simple-circuit/retro/scopewriter_pico50pwm/scopewriter_pico50pwm.ino

//    Pico Processor Scope Writer using PWM
//    Copyright (C) 2024  Simple-Circuit
//    This program displays a line of characters on an oscilloscope using
//    One I/O pin.
//
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

#include "pico/stdlib.h"
#include "hardware/pwm.h"
#include "hardware/clocks.h"

volatile word bc[128][8];    //ascii character pixel matrix
volatile word a[100];        //ascii character line

//Your oscilloscope horizontal scan time is us/div times total divisions
//My scope is 50us/div * 12 div = 6ms
//Character time is MAXCHAR * 7 * SYNCBIT * 2 = 5.6ms
//Character time must be less than the horizontal scan time
//Retrace time is Character time + SYNC1 + 2 * SYNC2 = 7.08ms
//Retrace time should be greater than the horizontal scan time

#define SYNC1 1000          //sync pulse delay counts us
#define SYNC2 240           //pre and post line delay us
#define MAXCHAR 50          //the size of the character display
#define SYNCBIT 8           //us clock pixel synchronization bit use 8,16,32

uint slice_num ;            //Global variable for PWM slice number

void setup() {
  //the PWM is set to 16 levels at 8MHz. Pin-14 is the output
    gpio_set_function(14, GPIO_FUNC_PWM);
    slice_num = pwm_gpio_to_slice_num(14);
    pwm_set_wrap(slice_num, 15);
    pwm_set_clkdiv(slice_num,1);
    pwm_set_chan_level(slice_num, PWM_CHAN_A, 8);
    pwm_set_enabled(slice_num, true);
 
  Serial.begin(115200); 
     
  int i;
  char message[] = "50 Character O'Scope Display #{67]*835?!14$%^&()=+/.,ABCDEFGHIJKLMNOPQRSTUVWXYZabcdefghijklmnopqrstuvwxyz?";
  for (i = 0; i < MAXCHAR; i++) a[i] = message[i];

//128 ascii character matrix values for a 5x7 pixel display
//A@
bc[ 0x40] [ 6 ] = B01110;
bc[ 0x40] [5 ] =  B10001;
bc[ 0x40] [4 ] =  B10111;
bc[ 0x40] [3 ] =  B11001;
bc[ 0x40] [ 2 ] = B10110;
bc[ 0x40] [ 1 ] = B10000;
bc[ 0x40] [ 0 ] = B01100;  
//A
bc[ 0x41] [ 6 ] = B00100;
bc[ 0x41] [5 ] =  B01010;
bc[ 0x41] [4 ] =  B10001;
bc[ 0x41] [3 ] =  B11111;
bc[ 0x41] [ 2 ] = B10001;
bc[ 0x41] [ 1 ] = B10001;
bc[ 0x41] [ 0 ] = B10001;
//B
bc[ 0x42] [ 6 ] = B11110;
bc[ 0x42] [ 5 ] = B10001;
bc[ 0x42] [ 4 ] = B10001;
bc[ 0x42] [ 3 ] = B11110;
bc[ 0x42] [ 2 ] = B10001;
bc[ 0x42] [ 1 ] = B10001;
bc[ 0x42] [ 0 ] = B11110;
//C
bc[ 0x43] [ 6 ] = B01111;
bc[ 0x43] [ 5 ] = B10000;
bc[ 0x43] [ 4 ] = B10000;
bc[ 0x43] [ 3 ] = B10000;
bc[ 0x43] [ 2 ] = B10000;
bc[ 0x43] [ 1 ] = B10000;
bc[ 0x43] [ 0 ] = B01111;
//D
bc[ 0x44] [ 6 ] = B11110;
bc[ 0x44] [ 5 ] = B10001;
bc[ 0x44] [ 4 ] = B10001;
bc[ 0x44] [ 3 ] = B10001;
bc[ 0x44] [ 2 ] = B10001;
bc[ 0x44] [ 1 ] = B10001;
bc[ 0x44] [ 0 ] = B11110;
//E
bc[ 0x45] [ 6 ] = B11111;
bc[ 0x45] [ 5 ] = B10000;
bc[ 0x45] [ 4 ] = B10000;
bc[ 0x45] [ 3 ] = B11110;
bc[ 0x45] [ 2 ] = B10000;
bc[ 0x45] [ 1 ] = B10000;
bc[ 0x45] [ 0 ] = B11111;
//F
bc[ 0x46] [ 6 ] = B11110;
bc[ 0x46] [ 5 ] = B10000;
bc[ 0x46] [ 4 ] = B10000;
bc[ 0x46] [ 3 ] = B11110;
bc[ 0x46] [ 2 ] = B10000;
bc[ 0x46] [ 1 ] = B10000;
bc[ 0x46] [ 0 ] = B10000;
//G
bc[ 0x47] [ 6 ] = B11111;
bc[ 0x47] [ 5 ] = B10000;
bc[ 0x47] [ 4 ] = B10000;
bc[ 0x47] [ 3 ] = B10011;
bc[ 0x47] [ 2 ] = B10001;
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
bc[ 0x7E] [ 5 ] = B00000;
bc[ 0x7E] [ 4 ] = B00000;
bc[ 0x7E] [ 3 ] = B01001;
bc[ 0x7E] [ 2 ] = B10110;
bc[ 0x7E] [ 1 ] = B00000;
bc[ 0x7E] [ 0 ] = B00000;
//< _
bc[ 0x7F] [ 6 ] = B00000;
bc[ 0x7F] [ 5 ] = B00000;
bc[ 0x7F] [ 4 ] = B00000;
bc[ 0x7F] [ 3 ] = B00000;
bc[ 0x7F] [ 2 ] = B00000;
bc[ 0x7F] [ 1 ] = B00000;
bc[ 0x7F] [ 0 ] = B11111;
}

//core-1 receives serial data and pushes it on to the end of the line buffer
void loop(){
  byte c;
  volatile unsigned int k;

  while ( Serial.available() == 0 );
  c = Serial.read();
  Serial.write(c);
  for (k = 0; k < (MAXCHAR-1); k++) a[k] = a[k+1]; 
    a[MAXCHAR-1] = c & 0xff;
}

void setup1(){

} 

//Core=2 modulates pin-14 with the raster scan values
void loop1() {
  volatile unsigned int i,j,k,d,b,n,hi;
  while(true){
  for (j = 0; j < 7; j++) {                        //raster has 7-levels
    pwm_set_chan_level(slice_num, PWM_CHAN_A, 0);  //pwm zero level
    delayMicroseconds(SYNC1);
    pwm_set_chan_level(slice_num, PWM_CHAN_A, 6);  //front porch and horizontal sync
    delayMicroseconds(SYNC2);
    hi = j + 8;                                    //on level is scan number plus 8
    for (i = 0; i< MAXCHAR; i++) {                 //all characters shown each line scan
    n = a[i];                                      //read the text buffer
    d = bc[n][j];                                  //look up the matrix value       
    b = 32;                                        //set the pixel shift bit to left most 
    for (k = 0; k <= 6; k++) {                     //do 7 shifts
     if ((d & b) != 0)   pwm_set_chan_level(slice_num, PWM_CHAN_A, hi); //set pixel On or Off
     else  pwm_set_chan_level(slice_num, PWM_CHAN_A, 6);
     b = b >> 1;                                   //shift to next pixel
     while ((time_us_32() & SYNCBIT)!= 0);         //synchronize on micro second clock bits
     while ((time_us_32() & SYNCBIT) == 0);
      }
    }
    delayMicroseconds(SYNC2);                      //back porch
   }
  } 
}
